cybernetic-m/LIDARino_robot/README.md

# LIDARino
This is the official repository of the Robot Programming subject in Artificial Intelligence and Robotics course at Sapienza University of Rome

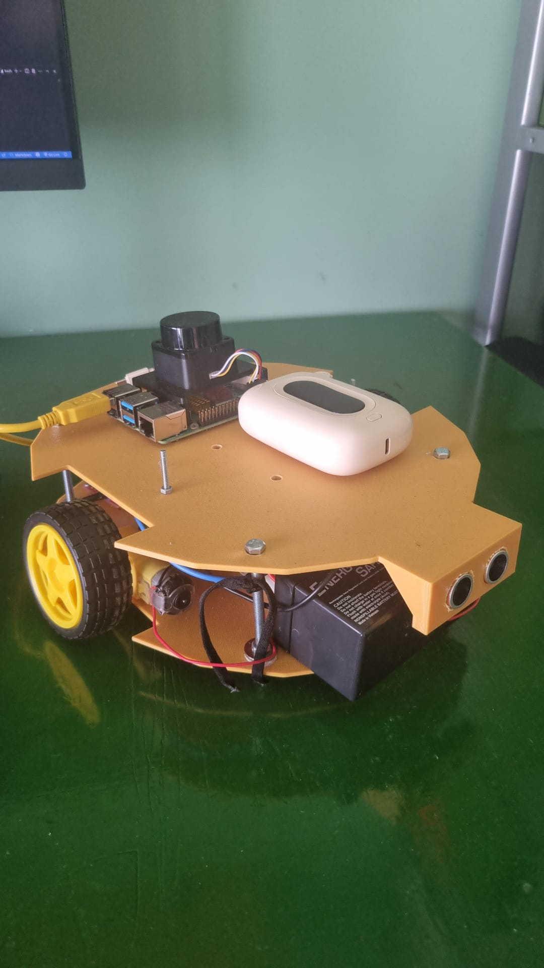
[picture p1: images/lidarino_v02.jpeg]


Description

FULL VIDEO HERE: https://drive.google.com/file/d/1uY1311wZvZpM1vVac2CnY4hhfMcjk1Bl/view?usp=drive_link

Description

# Project Structure 

```sh 
firmware
├── encoderWheel.cpp => Functions to read data from encoders
├── firmlib.h => header file for the whole firmware library 
├── firmware.ino => sketch that puts all the firmware together and that gets uploaded to the Arduino
├── Motors.cpp => Implementation of the class motors to control both motors
├── Motors.h => header file for the class motors to control both motors
├── ultrasound.cpp => Functions to request and read data from the ultrasound sensor
├── velocitiesCallback.cpp => Function that gets called when a new command from rosserial arrives
LIDARINO_WORKSPACE
├── build ...
├── devel ...
├── src
    ├── lidarino_pkg
        ├── config 
            ├── base_local_planner.yaml => local planner parameters
            ├── costmap_common.yaml => general costmap parameters
            ├── global_costmap.yaml => gloabal costmap parameters
            ├── local_costmap.yaml => local costmap parameters
        ├── launch
            ├── launch.launch => planning complete launcher
            ├── launch2.launch => everything except planning
            ├── launch2pi.launch => same as launch2 but no simulator map server to launch it separately
            ├── move_base.launch => only planning
            ├── pi.launch => same as launch2 but no simulator
            ├── Testing_Localization.launch => localization simulation
            ├── tfonly.launch => only tf nodes
        ├── maps
            ├── cappero_laser_odom_diag_2020-05-06-16-26-03.png => diag map
            ├── map.pgm => 1st configuration of the room
            ├── map.yml => yml file for the room map
            ├── map2.pgm => 2nd configuration of the room
            ├── map3.pgm => 3rd configuration of the room
            ├── sim_map.yaml => yaml file for the diag map
        ├── rviz
            ├── navigation.rviz => navigation package rviz configuration 
            ├── rviz_map_and_robot.rviz => rviz configuration for our localizer
        ├── src
            ├── dmap_localizer.cpp => implementation of a dmap based localizer 
            ├── localizer.cpp => node that uses the localizer to localize the robot in the map
            ├── simulation.cpp => simulation node to handle a virtual world with a map and robot with a lidar
            ├── odometry.cpp => node to do odometry based either on a simulated cmd_vel or the real one 
            ├── keyboard_interface.cpp => node to create a interface between the keyboard and the robot
            ├── pos_subscriber.cpp => node to test that the position is being published correctly
```

## INSTALLATION 

1. Clone the repository:  
 ```sh 
 git clone "https://github.com/cybernetic-m/LIDARino_robot"
```

2. Install ROS Noetic on your PC following these [instructions](https://wiki.ros.org/noetic/Installation/Ubuntu)

3. Configuring your ROS environment on your PC following these [instructions](https://wiki.ros.org/ROS/Tutorials/InstallingandConfiguringROSEnvironment)
   !!!Important: You need at least the catkin_ws!!!  
 
5. Install ROS Melodic on your Raspberry following these [instructions](https://wiki.ros.org/ROSberryPi/Installing%20ROS%20Melodic%20on%20the%20Raspberry%20Pi)

6. Configuring your ROS environment on Raspberry following these [instructions](https://wiki.ros.org/ROS/Tutorials/InstallingandConfiguringROSEnvironment)
   !!!Important: You need at least the catkin_ws!!!  
   
7. Install rosserial-arduino on the Arduino IDE with these [instructions](https://wiki.ros.org/rosserial_arduino/Tutorials/Arduino%20IDE%20Setup)

8. Install rosserial on Raspberry PI:
 ```sh 
cd ~/catkin_ws/
git clone "https://github.com/ros-drivers/rosserial"
catkin_make
```
9. Build our package:
 ```sh 
cd LIDARino_robot/LIDARINO_WORKSPACE
catkin_make
 ```
10. Launch the Arduino IDE and open the "firmware.ino"

11. Upload the firmware to your Arduino 

12. Install the lidar ros package from the repo and follow the instructions in the doc folder of the repo
 ```sh 
 git clone "https://github.com/LetsOKdo/sdk_ld06_raspberry_ros"
 ```

13. (Mapper - optional) follow point 7 of this tutorial https://yoraish.wordpress.com/2021/09/08/a-full-autonomous-stack-a-tutorial-ros-raspberry-pi-arduino-slam/ to install hector mapper to create a custom map

## LAUNCH

1. Start the lidar: 
 ```sh 
 cd sdk_ld06_raspberry_ros
 roslaunch ldlidar ld06.launch 
 ```

2. Start our package in another terminal:

 ```sh 
 cd LIDARino_robot/LIDARINO_WORKSPACE
 . ./devel/setup.bash
 roslaunch lidarino_pkg pi.launch
 ```

3. Start rosserial on the raspberry side (change the PORT based on your Arduino serial communication /dev/{your_port}, you can see it on [Arduino IDE](https://support.arduino.cc/hc/en-us/articles/4406856349970-Select-board-and-port-in-Arduino-IDE):

 ```sh 
 rosrun rosserial_python serial_node.py /dev/ttyACM0
 ```

4. Start the keyboard interface: 

 ```sh 
 cd LIDARino_robot/LIDARINO_WORKSPACE
 . ./devel/setup.bash
 rosrun lidarino_pkg keyboard_interface
 ```

## HARDWARE

1. Arduino UNO

2. Raspberry PI

3. DUAL H-BRIDGE L298N

4. 2 TT motors 

5. Ultrasonic sensor HC-SR04

6. Breadboard

7. Power Bank for the Raspberry and separate battery for the motors (9V+ recommended ) 

## VERSIONS
### v0.1
To design the base for our robot we started from a community shared base (https://www.tinkercad.com/things/daN7nNs5RfJ-line-follower-robot-v3) but modified it a lot to add wheel encoders, ultrasonic sensor, raspberry and a more secure mounting system for the motors and for the 2 bases. We also made it a bit bigger to fit all the new equipment. 

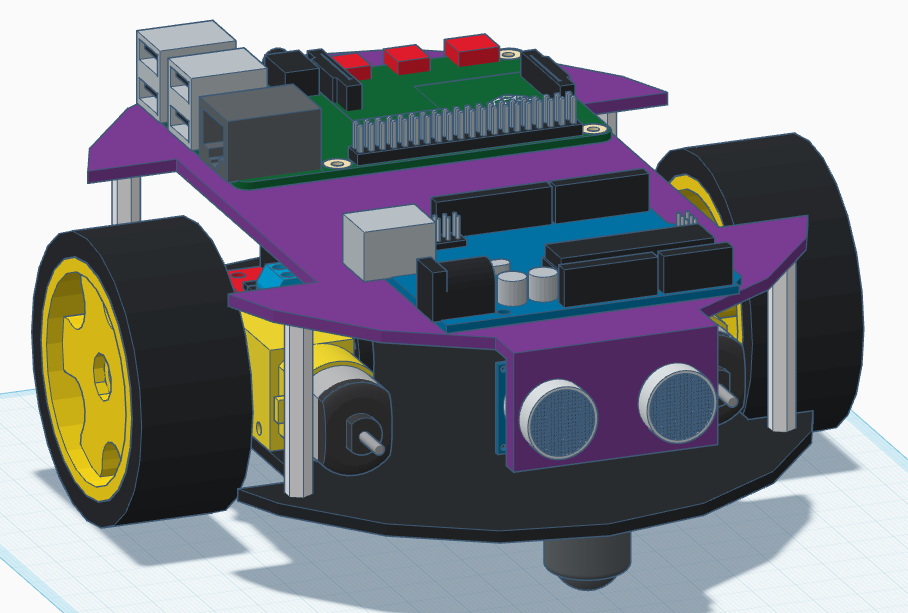
[picture p2: images/v01_1.png]


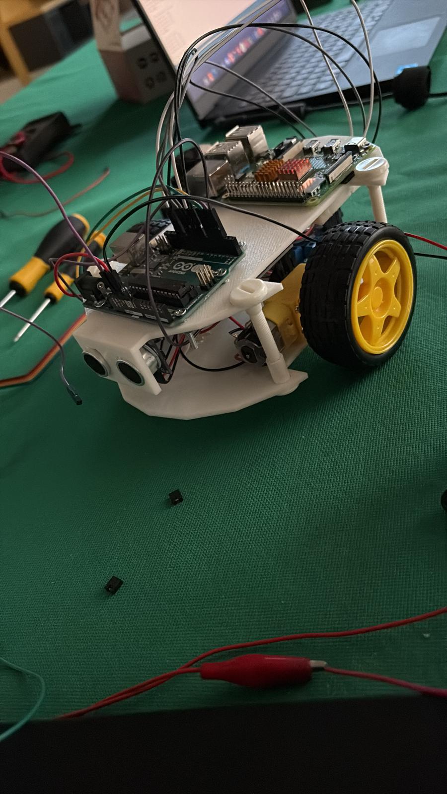
[picture p3: images/lidarinov01.jpeg]


From there we started to write the firmware on Arduino to read data from all the sensors and to control the motors, and we programmed it to be able to turn on it's axis

Description

and go "straight"...

Description

But the space was still too little to fit everything comfortably without fear of disconnects, for example we had to fit the breadboard upside down which made the sensors not very reliable. To fix that we created a new version bigger still, so that we could leave the top for the lidar and raspberry only and fit Arduino and all the sensor and motor and their wiring in the bottom base, that made it so that we could control it better.

### v0.2
The result of the v0.2 is available at these links if you want to 3D print them ;):

1. [Lower Chassis](https://www.tinkercad.com/things/b1n7qSNhbkg-chassisdownv02)
2. [Upper Chassis](https://www.tinkercad.com/things/dUmpkYZLHeb-chassisupv02)

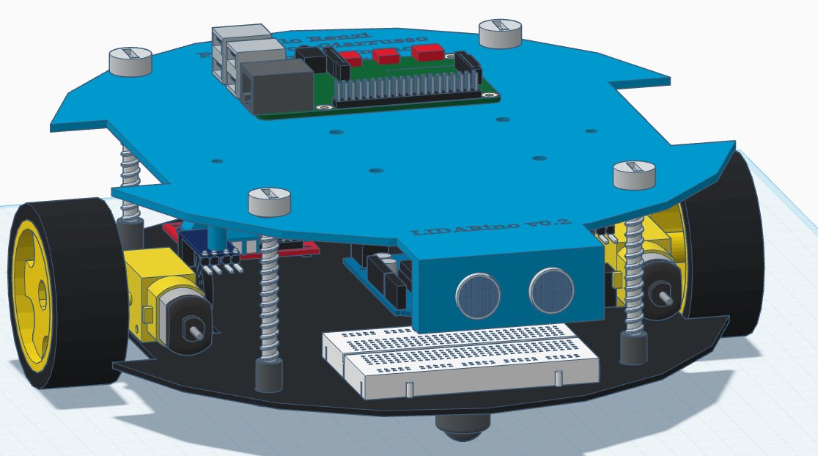
[picture p4: images/v02_1.png]


Description

## Authors
Massimo Romano (2043836) (https://github.com/cybernetic-m) 

Paolo Renzi (1887793) (https://github.com/RenziPaolo)

Francesco Giarrusso (1807094) (https://github.com/fragiarrusso)

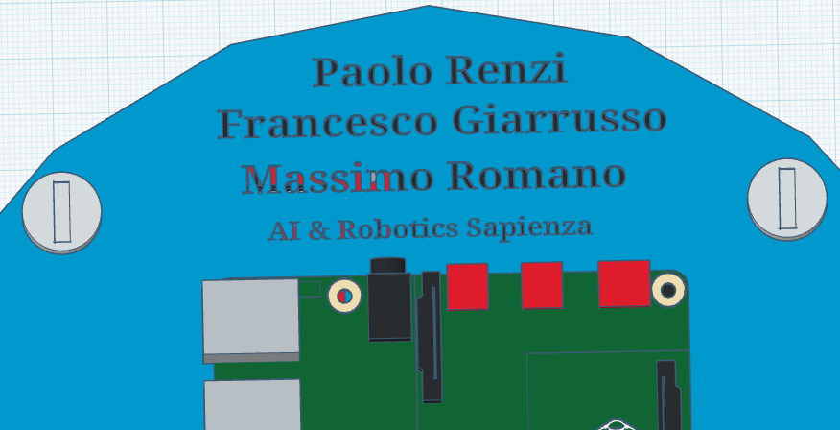
[picture p5: images/authors.png]
