cybernetic-m/LIDARino_robot/images/v02_2.png

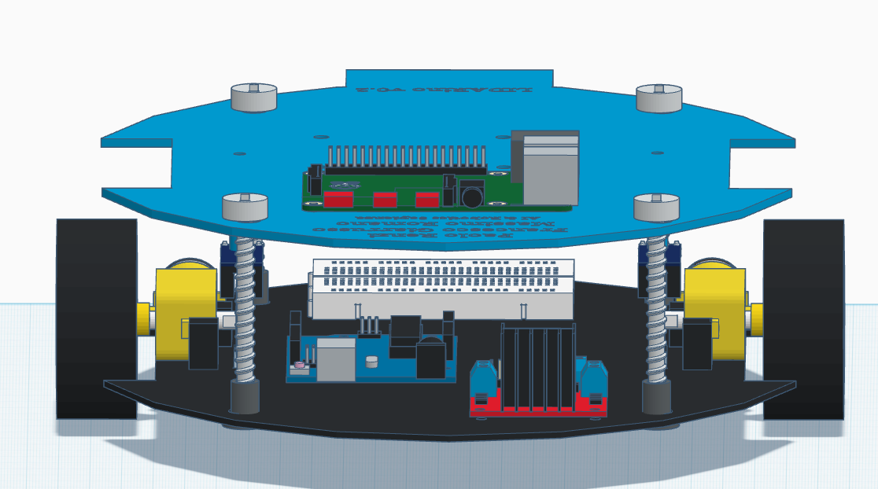
images/v02_2.png
