cybernetic-m/LIDARino_robot/images/v02_3.png

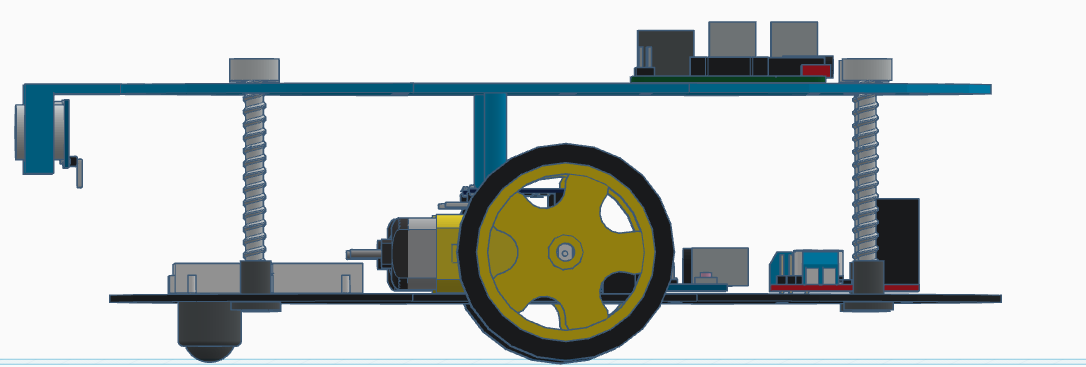
images/v02_3.png
