cybernetic-m/LIDARino_robot/images/v02_4.png

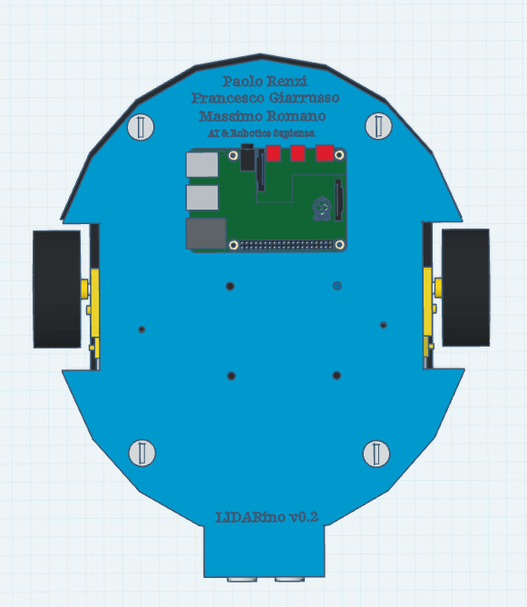
images/v02_4.png
