cybernetic-m/LIDARino_robot/firmware/firmlib.h

#ifndef FIRMLIB_H
#define FIRMLIB_H
#include <Arduino.h>
#include <geometry_msgs/Twist.h> 

// Ultrasound functions
void ultrasound_trigger(int trigger_pin);
long ultrasound_read(int echo_pin);

// Encoder Wheel functions
void encoderInterrupt_L();
void encoderInterrupt_R();
void encoderStart();
void computeVelocities();

// Callback function for Arduino Subscriber to cmd_vel topic
void velocitiesCallback(const geometry_msgs::Twist &velocities);


#endif
