cybernetic-m/LIDARino_robot/LIDARINO_WORKSPACE/src/lidarino_pkg/src/tf.cpp

#include <ros/ros.h>
#include <tf/transform_broadcaster.h>

int main(int argc, char** argv){
  ros::init(argc, argv, "robot_tf_publisher");
  ros::NodeHandle n;

  ros::Rate r(100);

  tf::TransformBroadcaster broadcaster;

  while(n.ok()){
    broadcaster.sendTransform(
      tf::StampedTransform(
        tf::Transform(tf::Quaternion(0, 0, 0, 1), tf::Vector3(0.7, 0.0, 0.0)),
        ros::Time::now(), "base_footprint", "lidar_frame"));
        
    broadcaster.sendTransform(
      tf::StampedTransform(
        tf::Transform(tf::Quaternion(0, 0, 0, 1), tf::Vector3(0.0, 0.0, 0.0)),
        ros::Time::now(), "map", "scanmatcher_frame"));

    r.sleep();
  }
}
