cybernetic-m/LIDARino_robot/(commit log)

2025-04-27 lidar driver
2025-04-28 start of the encoder wheel and motor control
2025-05-07 encoder total angle and pulses works
2025-05-07 encoder rps computation
2025-05-07 linear velocity at left and right wheel contact point
2025-05-08 first publisher subscriber and fixed std_msgs
    [draw_helpers.cpp, draw_helpers.h, grid.h]
2025-05-08 test send data to arduino
2025-05-08 added print
2025-05-10 cleaning and fixing little bug on visualization
    [simulation.cpp, world_item.cpp, world_item.h]
2025-05-10 start of the motor setup and encoder wheel cpp
2025-05-11 Firmware Update: moving functions of Encoders from main to encoderWheel.cpp
2025-05-11 simulation fixed again, it was correct before,
    [simulation.cpp]
2025-05-11 Firmware Update: encoderWheel.cpp finished
2025-05-11 added tf and odometry sim based
2025-05-11 fixed cmake libraries and odo ref
    [odometry.cpp]
2025-05-11 added frames
2025-05-12 Firmware Update: Motors.cpp class creation
2025-05-12 Firmware Update: Motors works!
2025-05-13 added lidar command and a tf transform
2025-05-13 fixed frame name
2025-05-13 added another frame
2025-05-13 add frame for mapper
2025-05-13 added more frames
2025-05-17 fix the simulation due to conflicts on topic name
    [simulation.cpp]
2025-05-18 Firmware Update: small fixes for V0.2
    [Motors.cpp, firmware.ino]
2025-05-18 command msg in LIDARINO WORKSPACE and little calibration of L in firmware
2025-05-18 FIRMWARE UPDATE: modification of Motors.cpp and Motors.h including ultrasound checks inside the Motor class
2025-05-18 FIRMWARE UPDATE: little change in velocity of the motors
2025-05-19 null pointer fix for Raspberry and test.ino works!
    [firmware.ino, keyboard_interface.cpp]
2025-05-19 fimware merge finished and elimination of time in Motors.cpp
2025-05-19 small fixes to the precedent push
    [Motors.h, firmlib.h, velocitiesCallback.cpp]
2025-05-19 velocity callback final merge and added min speed for motors
2025-05-31 conditional switch of maps
2025-06-02 updated odometry to use map origin
2025-06-02 updated subscribe to do odometry also on sim
2025-06-02 added raspberry pi launcher
2025-06-02 changed lidar topic name
2025-06-03 changes in firmware parameters for a bigger battery
2025-06-05 minor fixes and rearrange
    [odometry.cpp, simulation.cpp, world_item.cpp]
